h3llf/Euclid-2160/kicad/DriverBoardTMC2160.kicad_pcb

## KiCad design kicad/DriverBoardTMC2160.kicad_pcb (2026-06-25)

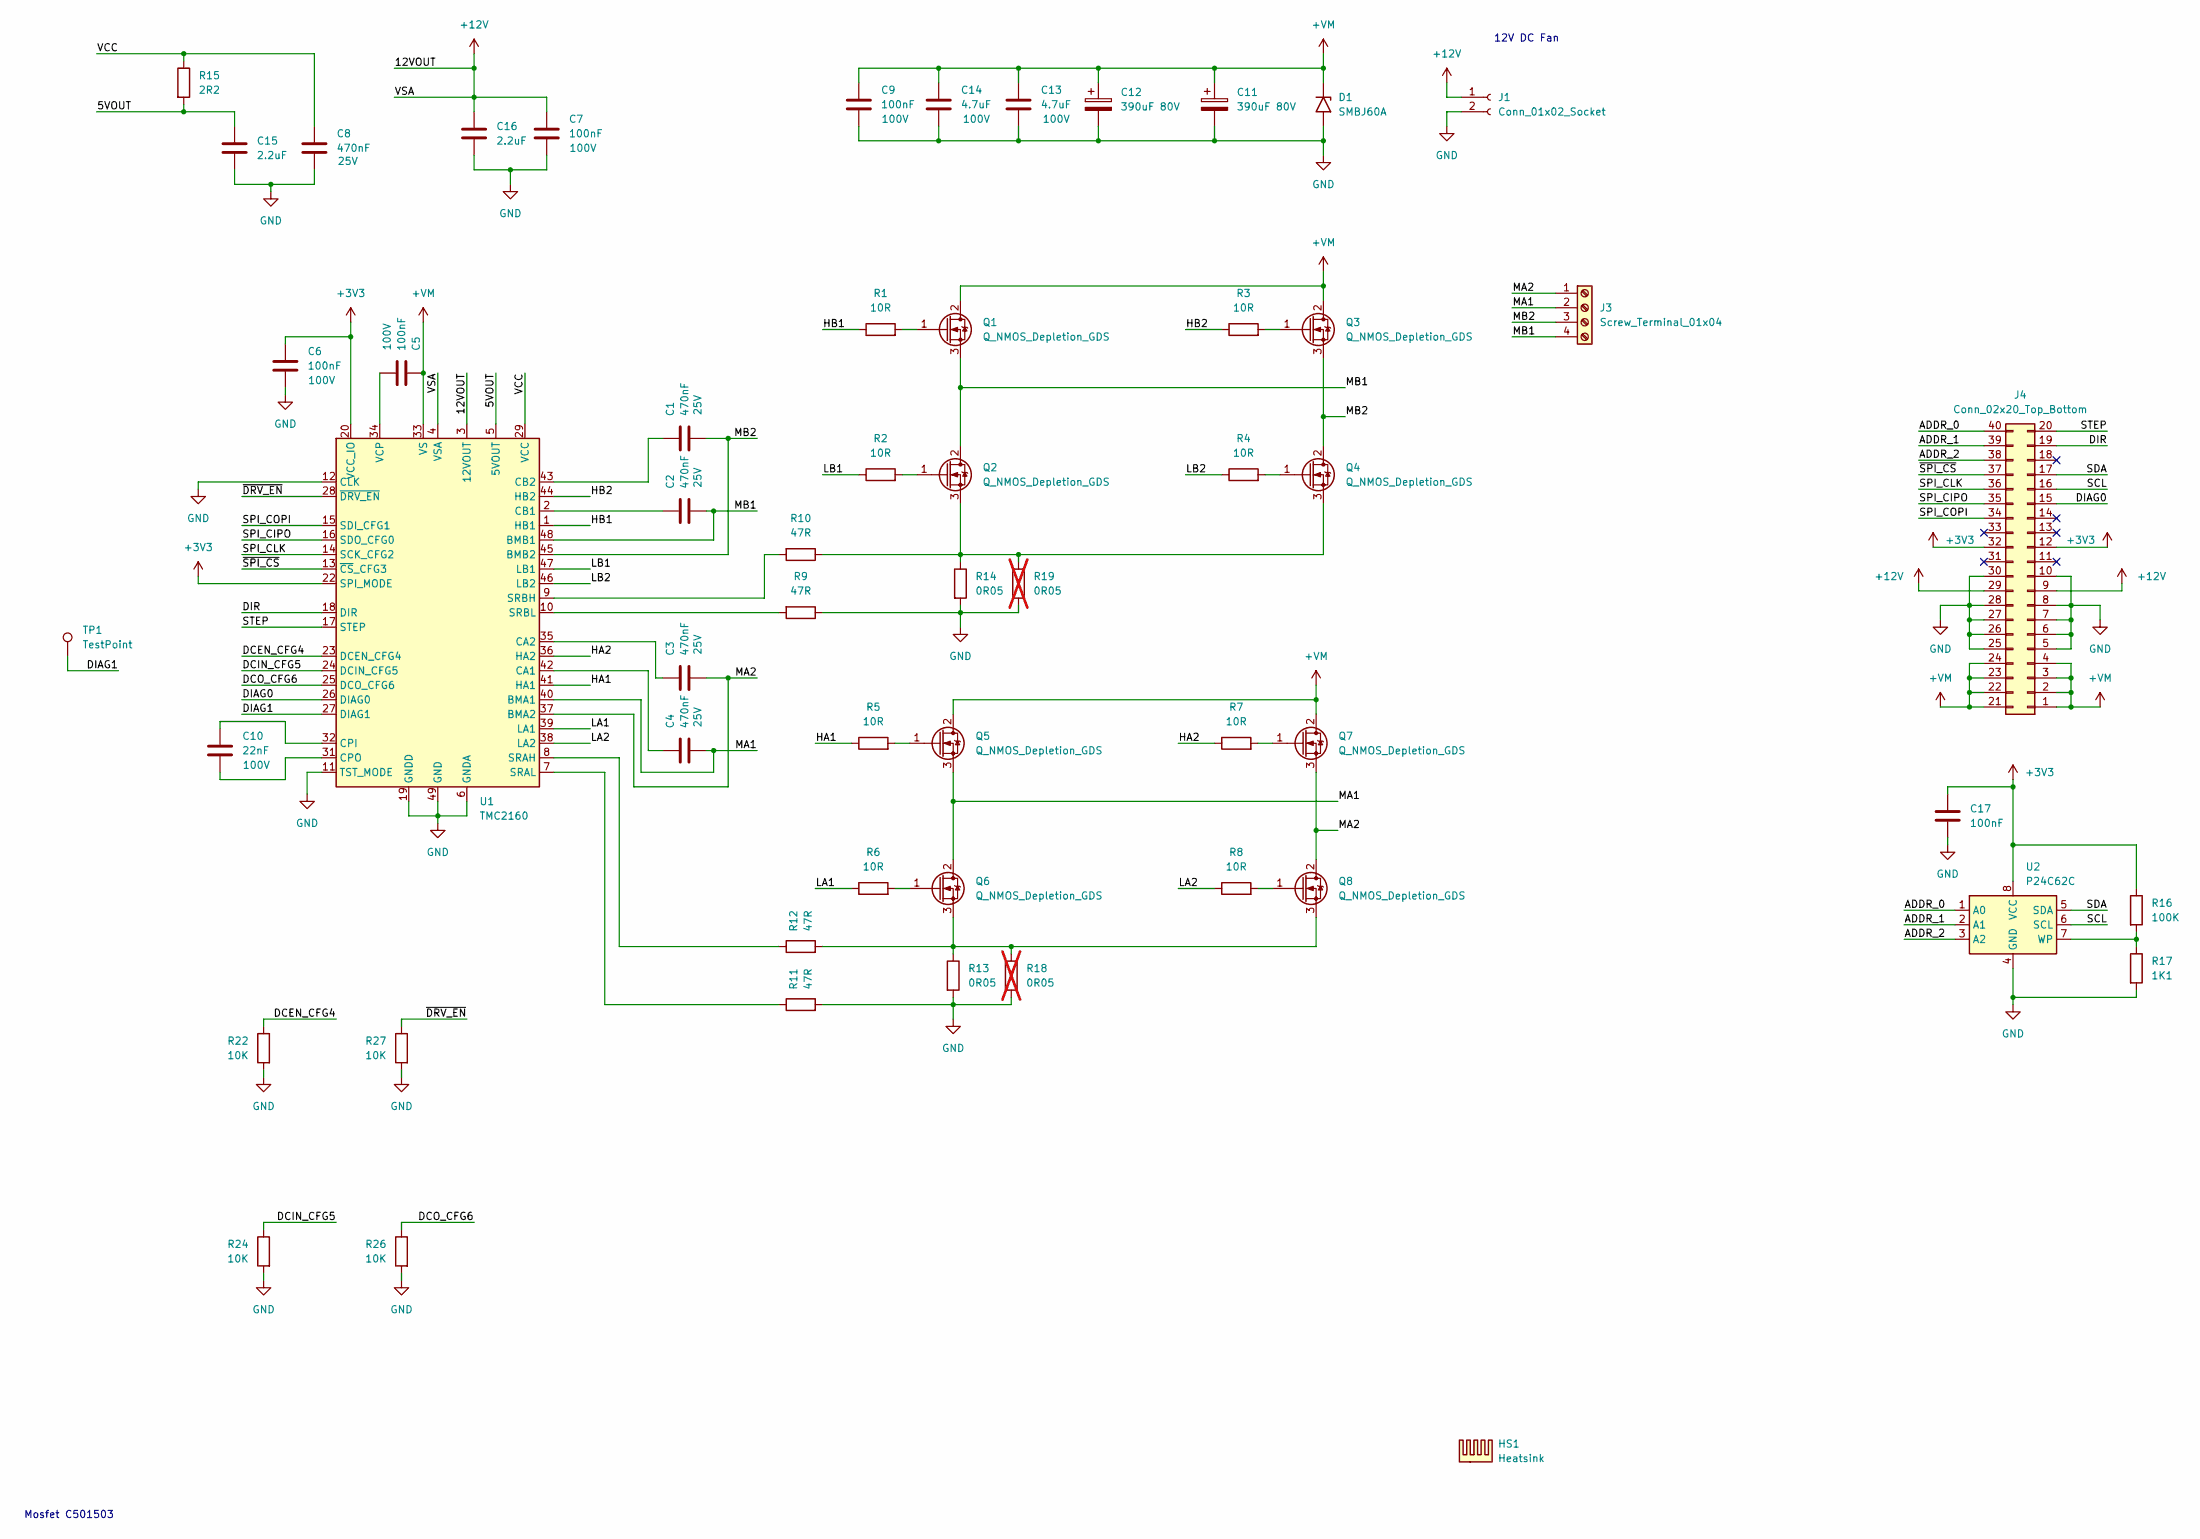
[picture p1: schematic DriverBoardTMC2160.kicad_sch]

Parts:
C1, C2, C3, C4, C8: 470nF; C_0603_1608Metric; Voltage 25V
C5, C6, C7, C9: 100nF; C_0603_1608Metric; Voltage 100V
C10: 22nF; C_0603_1608Metric; Voltage 100V
C11, C12: 390uF 80V; CP_Radial_D12.5mm_P5.00mm; LCSC C320012
C13, C14: 4.7uF; C_1210_3225Metric; Voltage 100V; LCSC C697607
C15, C16: 2.2uF; C_0603_1608Metric; LCSC C57895
C17: 100nF; C_0603_1608Metric
D1: SMBJ60A; D_SMB; LCSC C1974677
HS1: Heatsink; Heatsink_southbridge_35mm
J1: Conn_01x02_Socket; JST_XH_B2B-XH-A_1x02_P2.50mm_Vertical
J3: Screw_Terminal_01x04; TerminalBlock_Phoenix_MKDS-1,5-4_1x04_P5.00mm_Horizontal
J4: Conn_02x20_Top_Bottom; TX25-40P-LT-H1E
Q1, Q2, Q3, Q4, Q5, Q6, Q7, Q8: Q_NMOS_Depletion_GDS; PQFN-8-EP_6x5mm_P1.27mm_Generic; LCSC C431094
R1, R2, R3, R4, R5, R6, R7, R8: 10R; R_0603_1608Metric; LCSC C22859
R9, R10, R11, R12: 47R; R_0603_1608Metric
R13, R14: 0R05; R_2512_6332Metric; LCSC C2994645
R15: 2R2; R_0603_1608Metric; LCSC C112307
R16: 100K; R_0603_1608Metric
R17: 1K1; R_0603_1608Metric
R18, R19: 0R05; R_2512_6332Metric; LCSC C2994645; not fitted
R22, R24, R26, R27: 10K; R_0603_1608Metric; LCSC C22859
TP1: TestPoint; TestPoint_Pad_D2.0mm
U1: TMC2160; TQFP-48-1EP_7x7mm_P0.5mm_EP5x5mm_ThermalVias
U2: P24C62C; DFN-8-1EP_3x2mm_P0.5mm_EP1.36x1.46mm; LCSC C2977256

Connections:
+3V3: C6.1, C17.1, J4.12, J4.32, R16.1, U1.20 (VCC_IO), U1.21 (VCC_IO), U1.22 (SPI_MODE), U2.8 (VCC)
+12V: C7.1, C16.1, J1.1, J4.9, J4.29, U1.3 (12VOUT), U1.4 (VSA)
+VM: C5.1, C9.1, C11.1, C12.1, C13.1, C14.1, D1.1 (A1), J4.1, J4.2, J4.3, J4.4, J4.21, J4.22, J4.23, J4.24, Q1.2 (D), Q3.2 (D), Q5.2 (D), Q7.2 (D), U1.33 (VS)
/5VOUT: C15.1, R15.2, U1.5 (5VOUT)
/ADDR_0: J4.40, U2.1 (A0)
/ADDR_1: J4.39, U2.2 (A1)
/ADDR_2: J4.38, U2.3 (A2)
/DCEN_CFG4: R22.1, U1.23 (DCEN_CFG4)
/DCIN_CFG5: R24.1, U1.24 (DCIN_CFG5)
/DCO_CFG6: R26.1, U1.25 (DCO_CFG6)
/DIAG0: J4.15, U1.26 (DIAG0)
/DIAG1: TP1.1 (1_1), U1.27 (DIAG1)
/DIR: J4.19, U1.18 (DIR)
/HA1: R5.1, U1.41 (HA1)
/HA2: R7.1, U1.36 (HA2)
/HB1: R1.1, U1.1 (HB1)
/HB2: R3.1, U1.44 (HB2)
/LA1: R6.1, U1.39 (LA1)
/LA2: R8.1, U1.38 (LA2)
/LB1: R2.1, U1.47 (LB1)
/LB2: R4.1, U1.46 (LB2)
/MA1: C4.2, J3.2, Q5.3 (S), Q6.2 (D), U1.40 (BMA1)
/MA2: C3.2, J3.1, Q7.3 (S), Q8.2 (D), U1.37 (BMA2)
/MB1: C2.2, J3.4, Q1.3 (S), Q2.2 (D), U1.48 (BMB1)
/MB2: C1.2, J3.3, Q3.3 (S), Q4.2 (D), U1.45 (BMB2)
/SCL: J4.16, U2.6 (SCL)
/SDA: J4.17, U2.5 (SDA)
/SPI_CIPO: J4.35, U1.16 (SDO_CFG0)
/SPI_CLK: J4.36, U1.14 (SCK_CFG2)
/SPI_COPI: J4.34, U1.15 (SDI_CFG1)
/STEP: J4.20, U1.17 (STEP)
/VCC: C8.1, R15.1, U1.29 (VCC)
/~DRV_EN: R27.1, U1.28 (~DRV_EN)
/~SPI_CS: J4.37, U1.13 (~CS_CFG3)
GND: C6.2, C7.2, C8.2, C9.2, C11.2, C12.2, C13.2, C14.2, C15.2, C16.2, C17.2, D1.2 (A2), J1.2, J4.5, J4.6, J4.7, J4.8, J4.10, J4.25, J4.26, J4.27, J4.28, J4.30, R9.1, R11.2, R13.2, R14.2, R17.2, R18.2, R19.2, R22.2, R24.2, R26.2, R27.2, U1.6 (GNDA), U1.11 (TST_MODE), U1.12 (CLK), U1.19 (GNDD), U1.30 (GNDD), U1.49 (GND), U2.4 (GND), U2.9 (GND)
unnamed: Q1.1 (G), R1.2
unnamed: Q2.1 (G), R2.2
unnamed: Q2.3 (S), Q4.3 (S), R10.1, R14.1, R19.1
unnamed: Q3.1 (G), R3.2
unnamed: Q4.1 (G), R4.2
unnamed: Q5.1 (G), R5.2
unnamed: Q6.1 (G), R6.2
unnamed: Q6.3 (S), Q8.3 (S), R12.2, R13.1, R18.1
unnamed: Q7.1 (G), R7.2
unnamed: Q8.1 (G), R8.2
unnamed: C4.1, U1.42 (CA1)
unnamed: C3.1, U1.35 (CA2)
unnamed: C2.1, U1.2 (CB1)
unnamed: C1.1, U1.43 (CB2)
unnamed: C10.1, U1.32 (CPI)
unnamed: C10.2, U1.31 (CPO)
unnamed: R12.1, U1.8 (SRAH)
unnamed: R11.1, U1.7 (SRAL)
unnamed: R10.2, U1.9 (SRBH)
unnamed: R9.2, U1.10 (SRBL)
unnamed: C5.2, U1.34 (VCP)
unnamed: R16.2, R17.1, U2.7 (WP)

Notes on the sheet:
12V DC Fan
Mosfet C501503

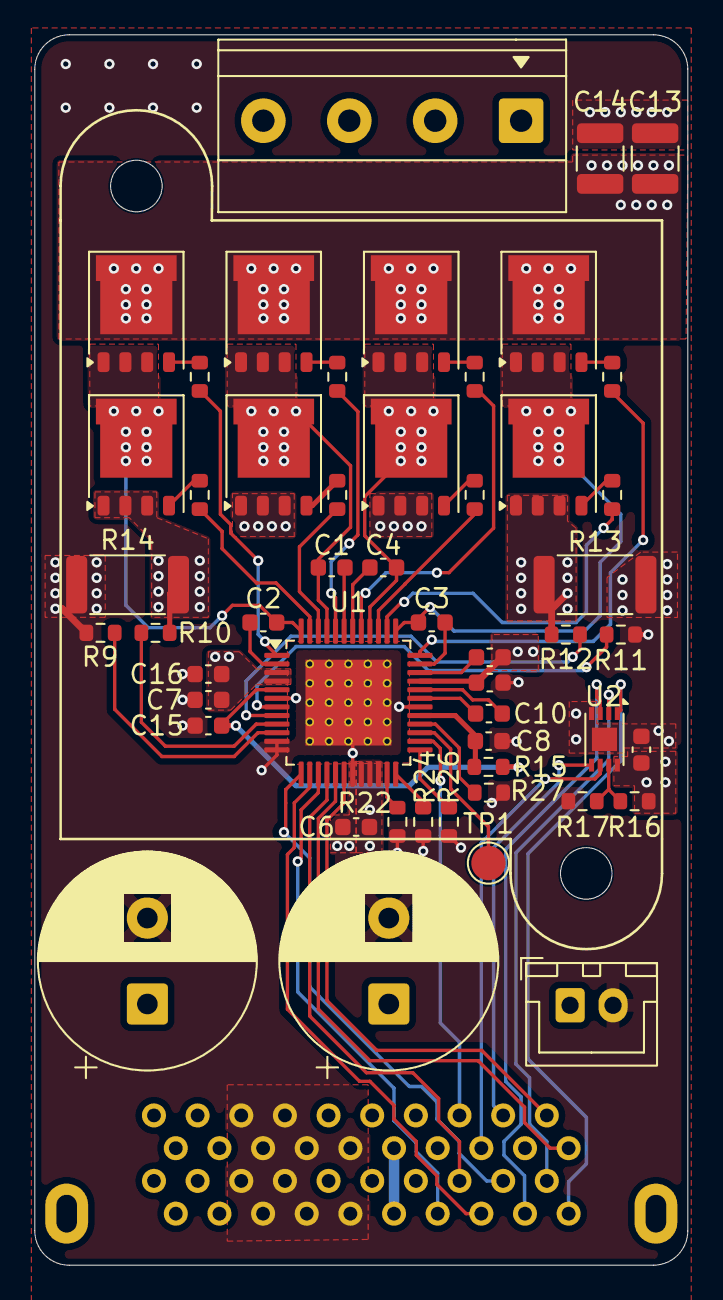
[picture p2: board DriverBoardTMC2160.kicad_pcb from above]

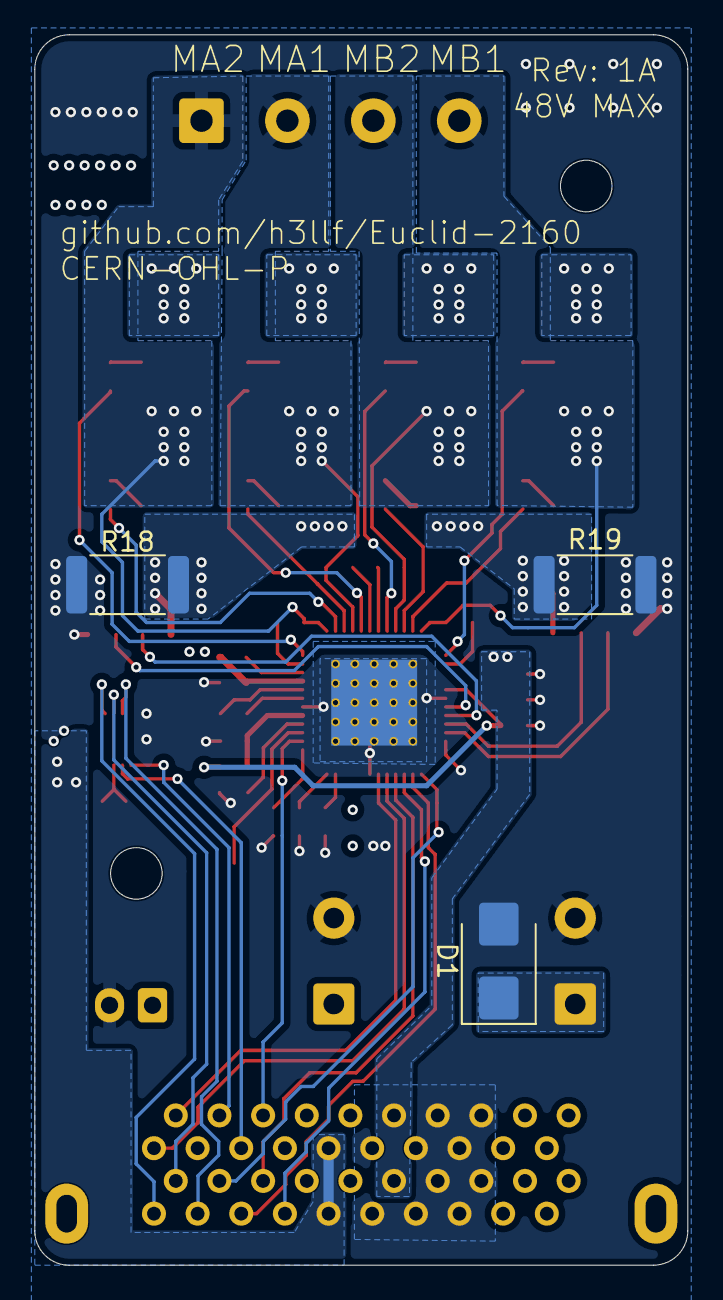
[picture p3: board DriverBoardTMC2160.kicad_pcb from below]

Board: 4 copper layers, 38.0 x 71.6 mm, 56 parts (3 on the bottom side), 57 nets.
