h3llf/Euclid-2160/(commit log)

2026-06-25 Rev 1A
    [DriverBoardTMC2160.kicad_pcb, DriverBoardTMC2160.kicad_sch]
2026-06-25 Deleted old model
    [DriverBoardTMC2160.step]
