h3llf/Euclid-2160/(notices)

Notices in the files:
kicad/DriverBoardTMC2160.kicad_pcb:
CERN-OHL-P
